ryood/MIX0401/eagle/MIX0401_brd.png

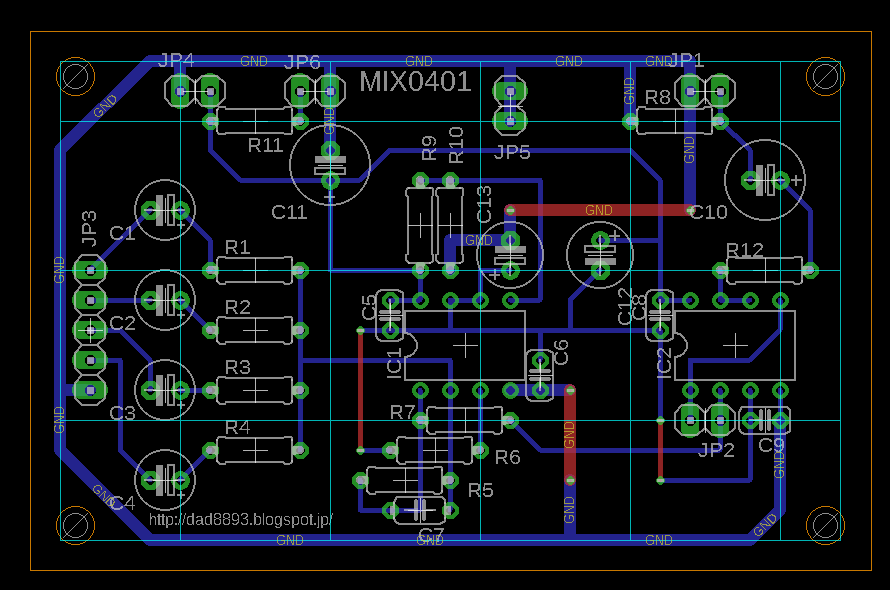
eagle/MIX0401_brd.png
