ryood/MIX0401/eagle/MIX0401_sch.png

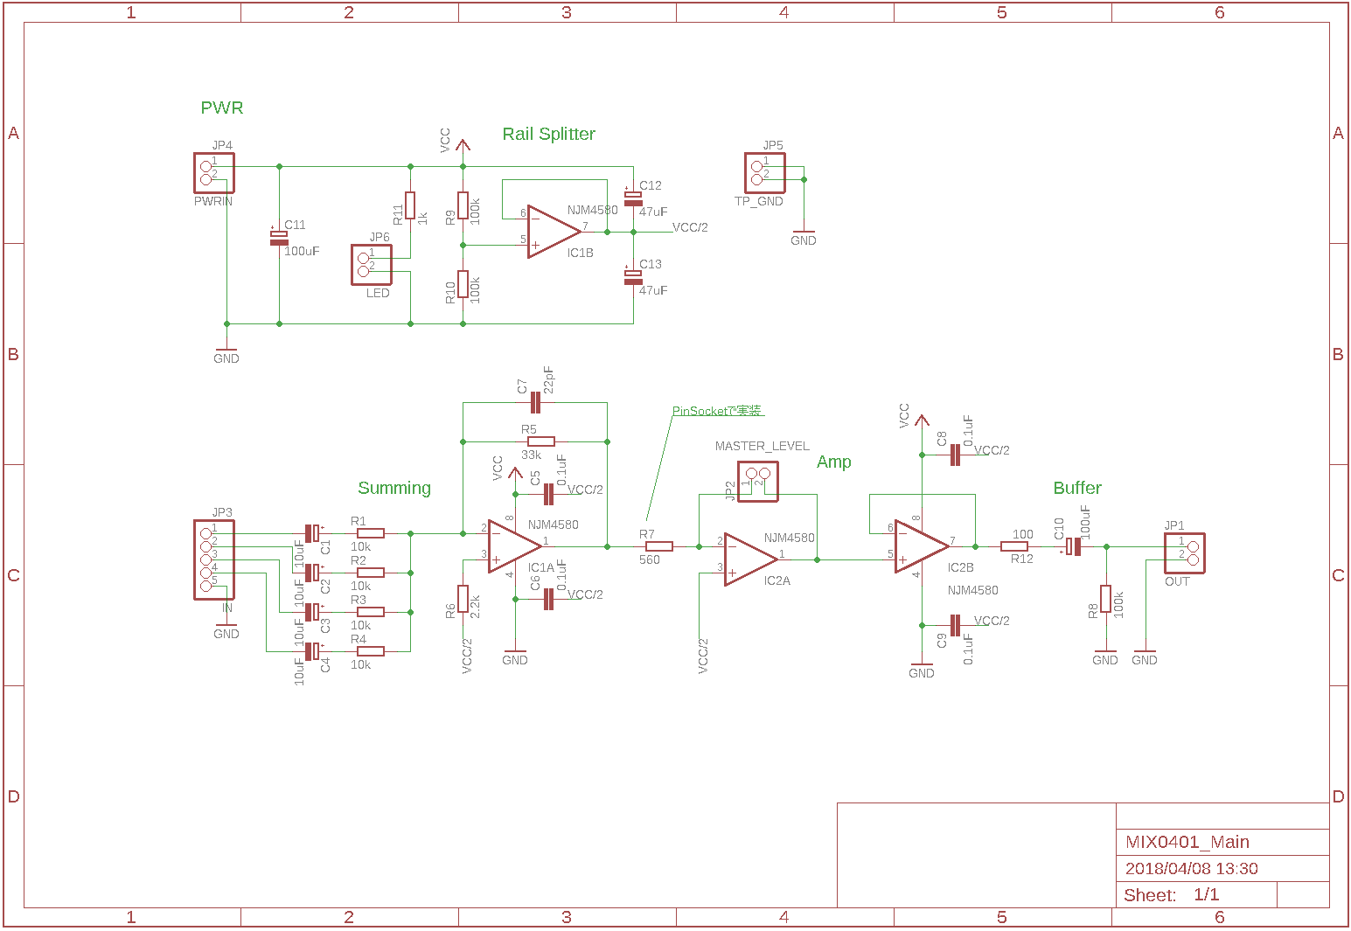
eagle/MIX0401_sch.png
