ryood/MIX0401/MIX0401_Fchara.png

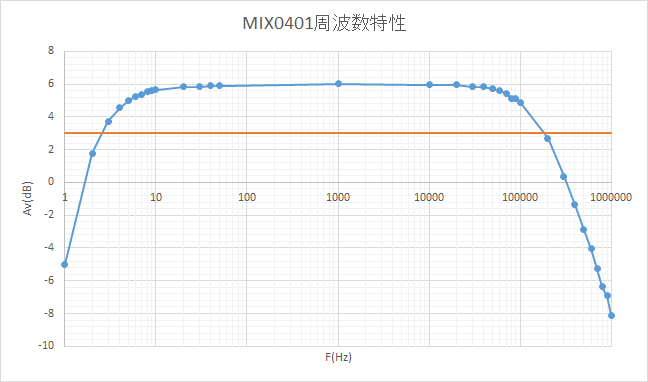
MIX0401_Fchara.png
