ryood/MIX0401/MIX0401ケース内配線_ブレッドボード.png

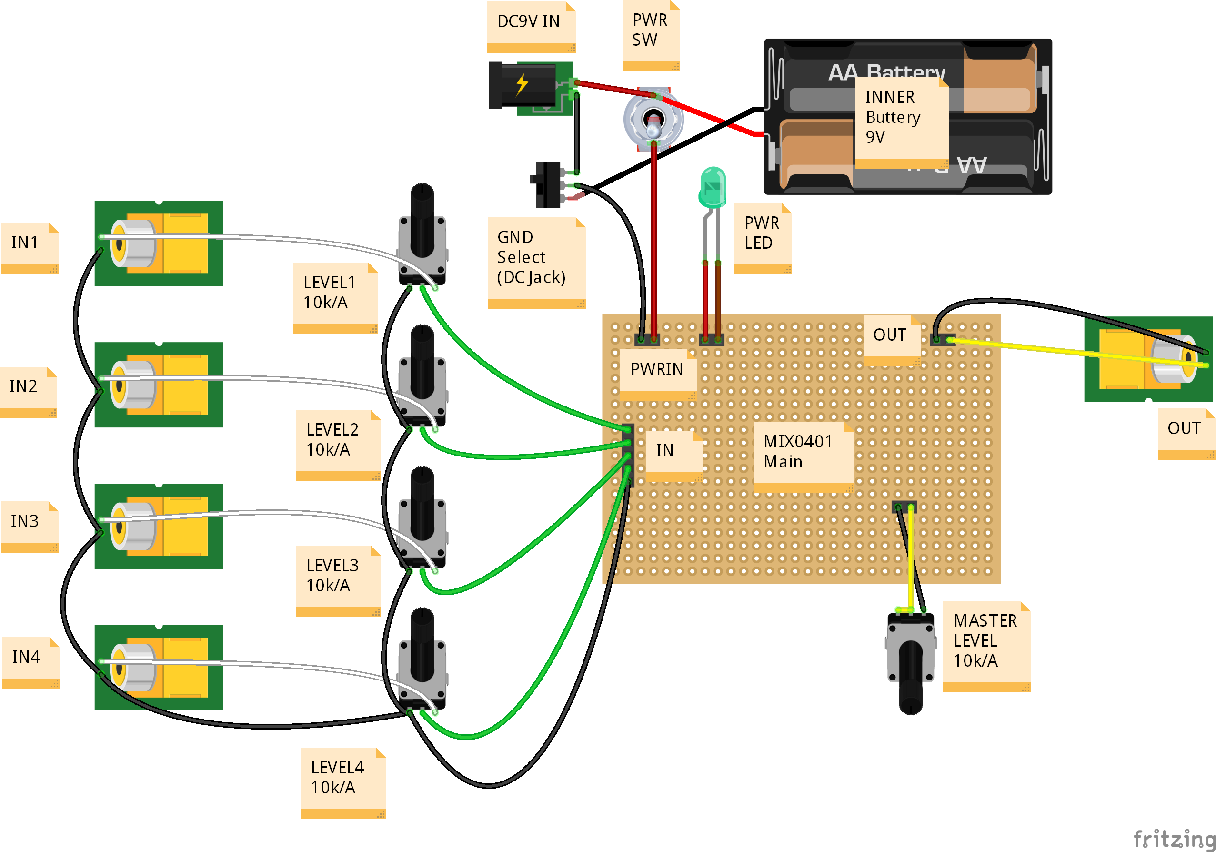
MIX0401ケース内配線_ブレッドボード.png
