ryood/MIX0401/spice/MIX0401_4IN_tran.png

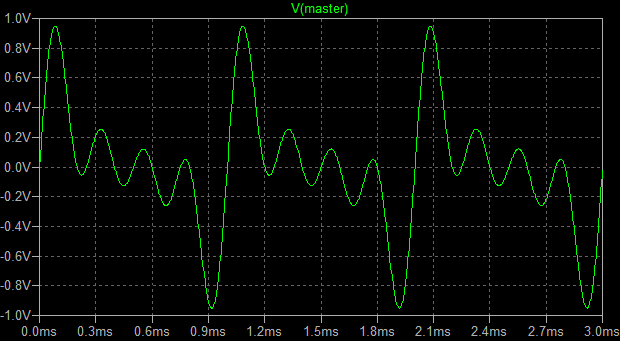
spice/MIX0401_4IN_tran.png
