ryood/MIX0401/spice/MIX0401_sim.png

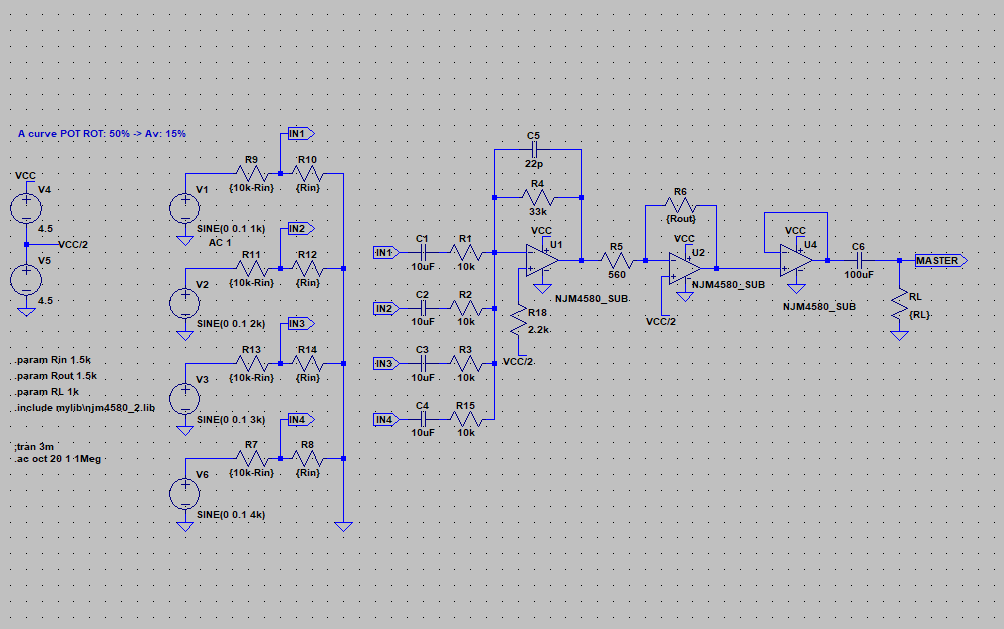
spice/MIX0401_sim.png
