ryood/MIX0401/(list of files, cad)

Other CAD files:
case/MIX0401_case_TS-1.dwg
