ryood/MIX0401/spice/MIX0401.asc

C1: cap; 10uF
C2: cap; 10uF
C3: cap; 10uF
C4: cap; 10uF
C5: cap; 22p
C6: cap; 100uF
R1: res; 10k
R2: res; 10k
R3: res; 10k
R4: res; 33k
R5: res; 560
R6: res; {Rout}
R7: res; {10k-Rin}
R8: res; {Rin}
R9: res; {10k-Rin}
R10: res; {Rin}
R11: res; {10k-Rin}
R12: res; {Rin}
R13: res; {10k-Rin}
R14: res; {Rin}
R15: res; 10k
R18: res; 2.2k
RL: res; {RL}
U1: opamp2; NJM4580_SUB
U2: opamp2; NJM4580_SUB
U4: opamp2; NJM4580_SUB
V1: voltage; SINE(0 0.1 1k); AC 1
V2: voltage; SINE(0 0.1 2k)
V3: voltage; SINE(0 0.1 3k)
V4: voltage; 4.5
V5: voltage; 4.5
V6: voltage; SINE(0 0.1 4k)
Named nets: VCC, IN1, IN2, IN3, MASTER, 0, IN4, VCC/2
;tran 3m
.ac oct 20 1 1Meg
A curve POT ROT: 50% -> Av: 15%
.param Rin 1.5k
.param Rout 1.5k
.param RL 1k
.include mylib\
jm4580_2.lib
