ryood/MIX0401/spice/MIX0301.asc

C1: cap; 10uF
C2: cap; 10uF
C3: cap; 10uF
R1: res; 10k
R2: res; 10k
R3: res; 10k
R4: res; 56k
R5: res; 820
R6: res; {Rout}
R9: res; {10k-Rin}
R10: res; {Rin}
R11: res; {10k-Rin}
R12: res; {Rin}
R13: res; {10k-Rin}
R14: res; {Rin}
RL: res; {RL}
U1: UniversalOpamp2
U2: UniversalOpamp2
V1: voltage; SINE(0 1 1k); AC 1
V2: voltage; SINE(0 0 1k)
V3: voltage; SINE(0 0 1k)
V4: voltage; 5
V5: voltage; -5
Named nets: 0, VCC, VEE, IN1, IN2, IN3, OUT
;tran 3m
.ac oct 20 1 1Meg
A curve POT ROT: 50% -> Av: 15%
.param Rin 1.5k
.param Rout 1.5k
.param RL 1k
