ryood/MIX0401/(list of files, drawings)

Other design files:
fritzing/MIX0401_Test.fzz
fritzing/MIX0401_Test_Master.fzz
fritzing/MIX0401ケース内配線.fzz
