ryood/MIX0401/fritzing/MIX0401_Test_ブレッドボード.png

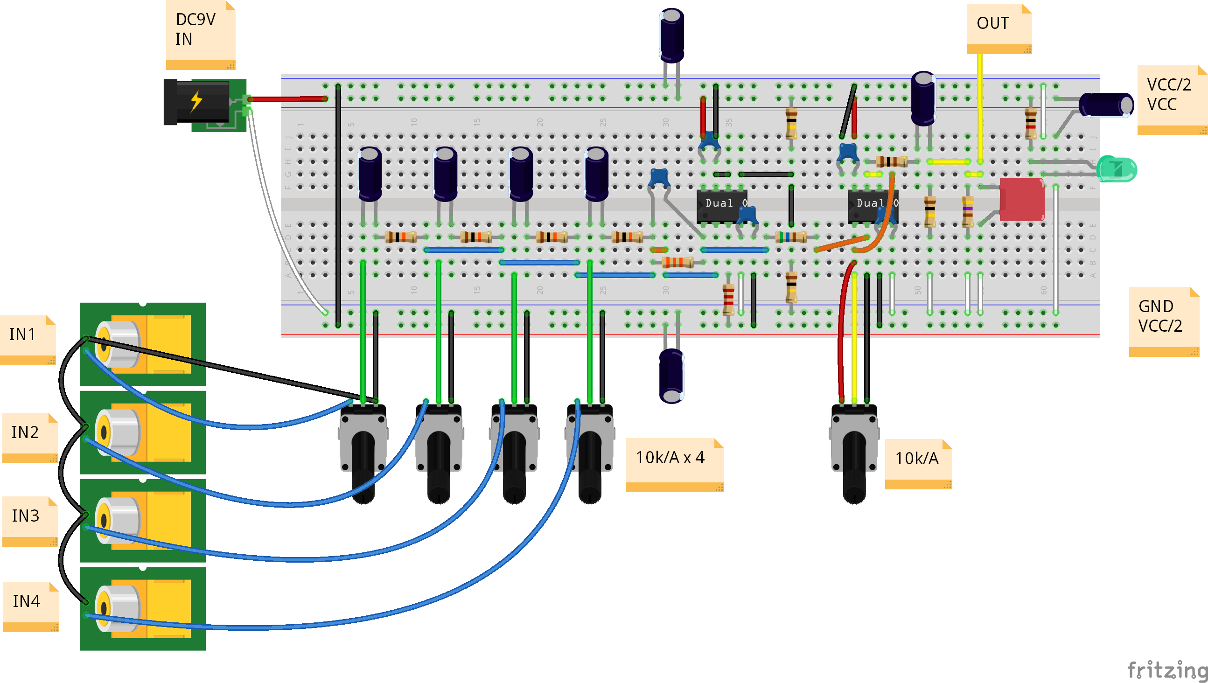
fritzing/MIX0401_Test_ブレッドボード.png
