ryood/MIX0401/(commit log)

2018-03-27 before for test
    [MIX0401_ケース内配線図.fzz]
2018-04-01 Add: fritzing files
    [MIX0401.fzz]
2018-04-02 Use Virtual-GND in spice of MIX0401
2018-04-04 Add: Eagle files
    [MIX0401_Main.brd, MIX0401_Main.sch]
2018-04-07 Update: Eagle files
    [MIX0401_Main.brd, MIX0401_Main.sch, MIX0401ケース内配線.fzz]
2018-04-12 はんだ付け完了
    [MIX0401 周波数特性.xlsx, MIX0401.fzz, MIX0401_Main.brd, MIX0401_Main.sch, MIX0401_Test.fzz, MIX0401_case_TS-1.dwg, MIX0401_ケース内配線図.fzz, MIX0401ケース内配線.fzz]
2018-04-22 Update: case design
    [MIX0401_case_TS-1.dwg]
2018-04-24 Update: ケース内配線
    [MIX0401ケース内配線.fzz]
